YujiKF/PMR3420-RoboParalelo/README.md

# PMR3420-RoboParalelo
Tudo que é relevante ao desenvolvimento do robô paralelo para a matéria PMR3420, estão organizados os documentos necessários, códigos e uma Wiki explicando um pouco da teoria de cada componente.
