YujiKF/PMR3420-RoboParalelo/(list of files, cad)

Other CAD files:
Documentos/Mecânica/mecanismo/motor/cubo_e_eixo.ipt
Documentos/Mecânica/mecanismo/motor/eixo_motor.ipt
Documentos/Mecânica/mecanismo/motor/suporte_L_motor.ipt
Documentos/Mecânica/mecanismo/suporte_caneta.ipt
Mecânica/mecanismo/motor/OldVersions/cubo_e_eixo.0002.ipt
Mecânica/mecanismo/motor/OldVersions/motor_motando.0001.iam
