YujiKF/PMR3420-RoboParalelo/(threads)

Thread 2 (2025-03-29):

Desenvolvimento da placa

YujiKF, 2025-03-29:
Projetar a placa [necessária para o robô](https://github.com/YujiKF/PMR3420-RoboParalelo/blob/main/Documentos/Conexoes%20PI-7%202025.pdf), aqui. Cabe aqui fazer o esquemático e PCB da placa que será utilizada.

É importante saber que a placa será feita da mesma forma que a de PMR3406 (Microcontroladores), logo, será de apenas uma face e com restrições parecidas (tamanho, uso de jumpers na horizontal/vertical, etc).

Thread 4 (2025-03-29):

PCB

YujiKF, 2025-03-29:
Issue para acompanhar o desenvolvimento da PCB que será produzida com a mesma máquina de PMR3406.

Thread 5 (2025-03-29):

Compra de materiais

YujiKF, 2025-03-29:
Criação de[ planilha ](https://docs.google.com/spreadsheets/d/1Cy9gskSDtoIPbhkmRvqXv943JPoP1iQV_0-sLY41qnc/edit?usp=sharing) para seleção de materiais.
