YujiKF/PMR3420-RoboParalelo/Documentos/Esquemáticos/Esquemático PIC - PI7.pdf

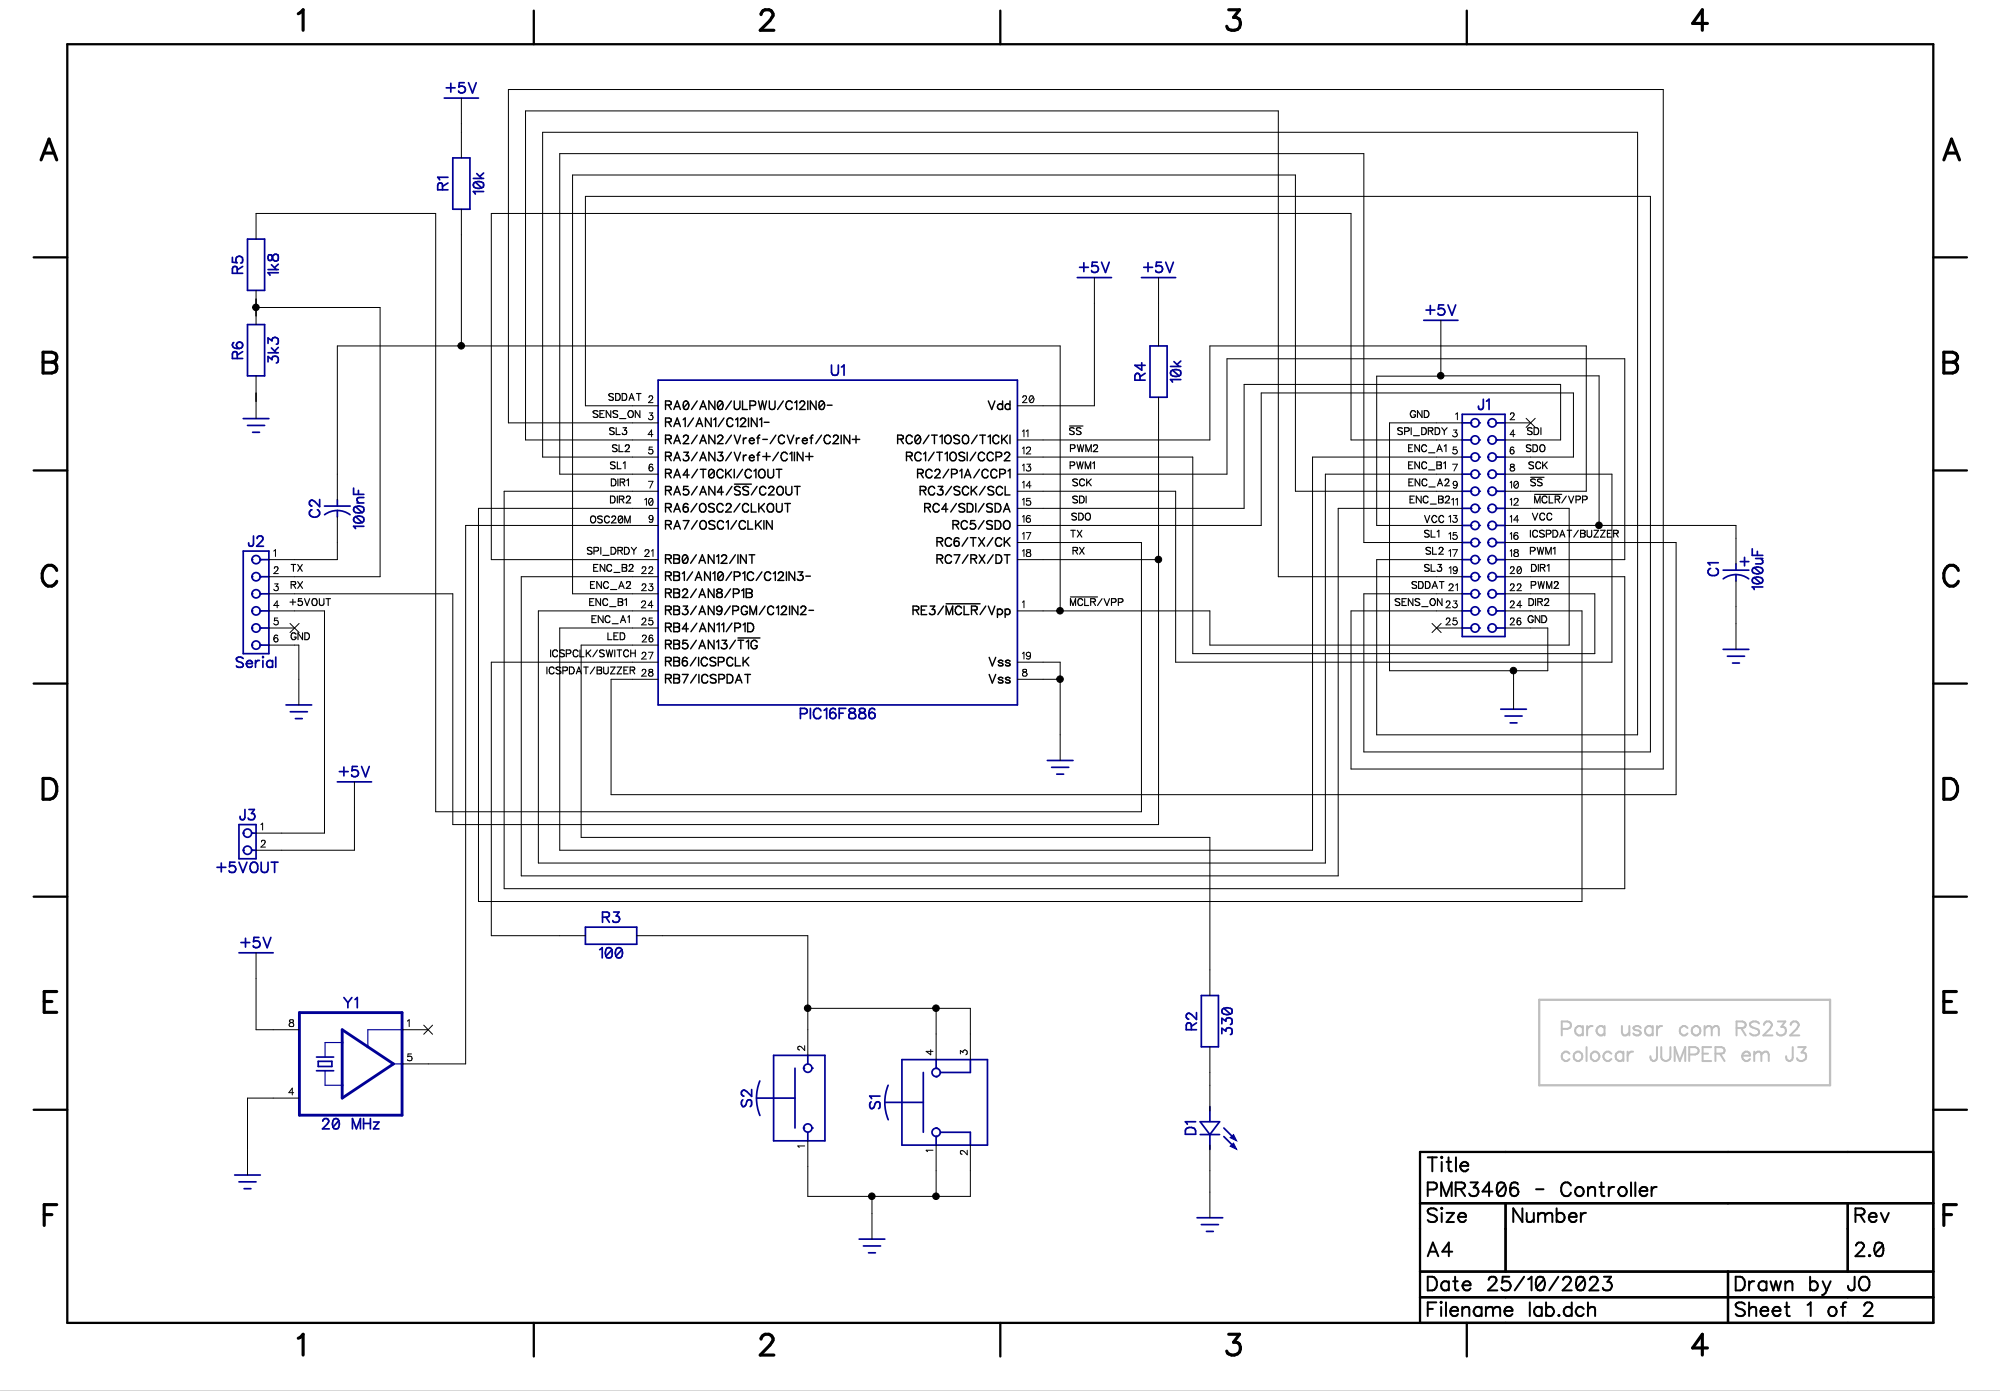
[picture p8: page 1]

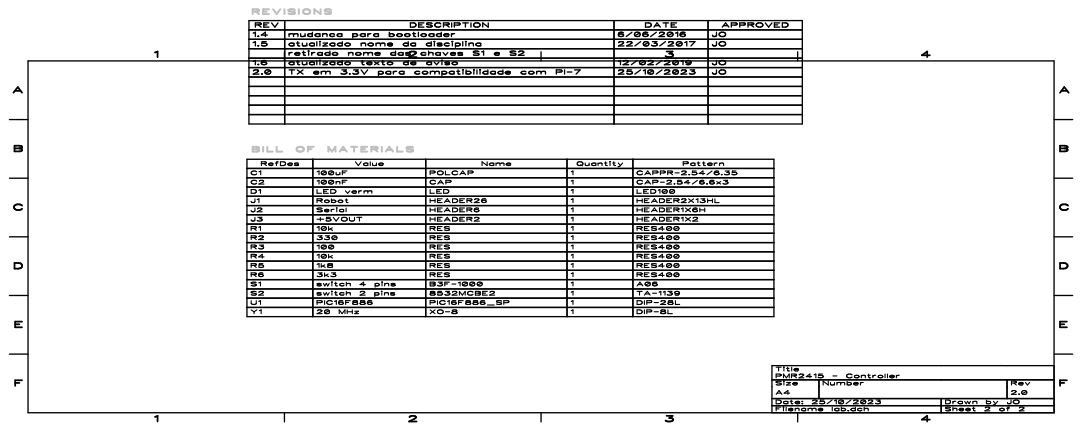
[picture p9: page 2]

DESCRIPTION mudanca para bootloader atualizado nome da disciplina retirado nome das chaves S | DATE 6/06/2016 22/03/2017 | APPROVED JOJO

1.6 2.0 | atualizado texto de aviso TX em 3.3V para compatibilidade com PI | 12/02/2019 25/10/2023 - | JOJO 7

Value 100uF 100nF LED verm Robot Serial +5VOUT 10k

Name POLCAP CAP LED HEADER26 HEADER6

HEADER
RES RES RES RES RES RES B3F

switch
4 pins switch 2 pins PIC16F886 20 MHz
