YujiKF/PMR3420-RoboParalelo/Documentos/Moodle/Conexoes PI-7 2025.pdf

M1

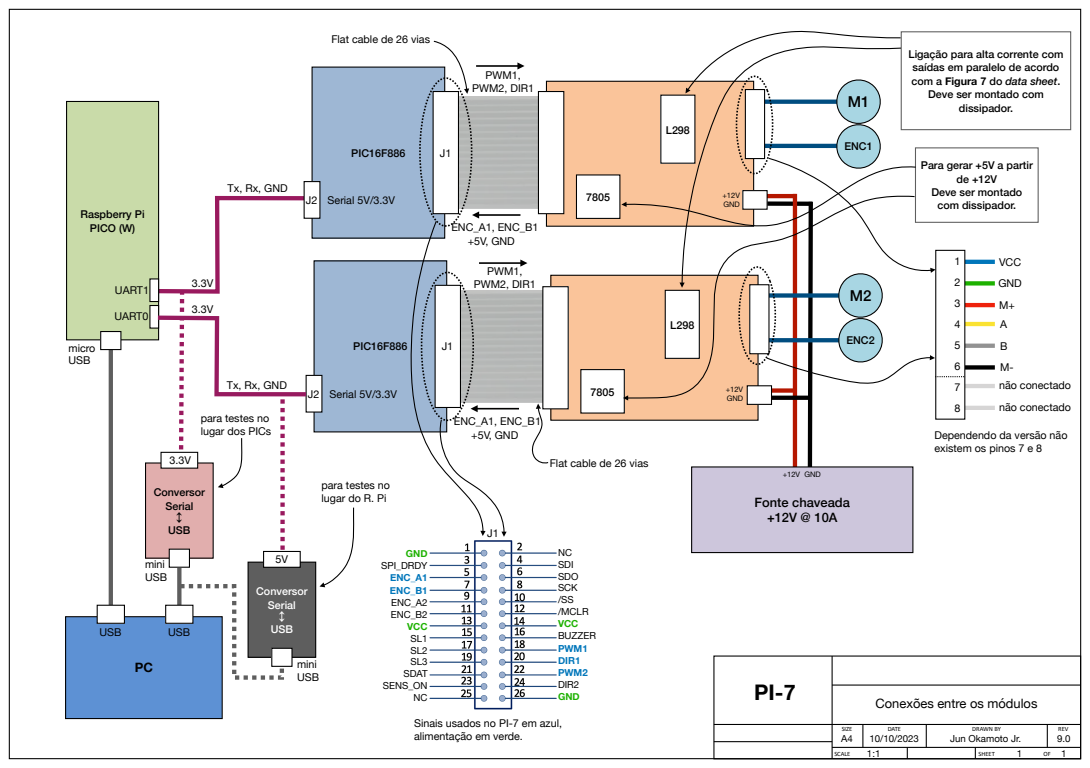
[picture p10: page 1]
SIZE; DATE; DRAWN BY; REV; SCALE; SHEET; Conexões entre os módulos; Jun Okamoto Jr.; micro USB; ENC1; Raspberry Pi PICO (W); UART0; UART1; PWM1, PWM2, DIR1; USB; Conversor Serial ↕︎ USB; PIC16F886; J2 Serial 5V/3.3V; ENC_A1, ENC_B1 +5V, GND; ENC2; Fonte chaveada +12V @ 10A; VCC; GND; não conectado; GND SPI_DRDY ENC_A1 ENC_B1 ENC_A2 ENC_B2 VCC SL1 SL2 SL3 SDAT SENS_ON NC; NC SDI SDO SCK /SS /MCLR VCC BUZZER PWM1 DIR1 PWM2 DIR2 GND; +12V GND; 5V mini USB; mini USB

Flat cable de 26 vias

Ligação para alta corrente com
saídas em paralelo de acordo
com a Figura 7 do data sheet.
Deve ser montado com
dissipador.

Para gerar +5V a partir
Deve ser montado
com dissipador.

Tx, Rx, GND

para testes no
lugar dos PICs

Dependendo da versão não
existem os pinos 7 e 8

lugar do R. Pi

Sinais usados no PI-7 em azul,
alimentação em verde.
