YujiKF/PMR3420-RoboParalelo/Documentos/Esquemáticos/Esquemático Giovanni - PI7.pdf

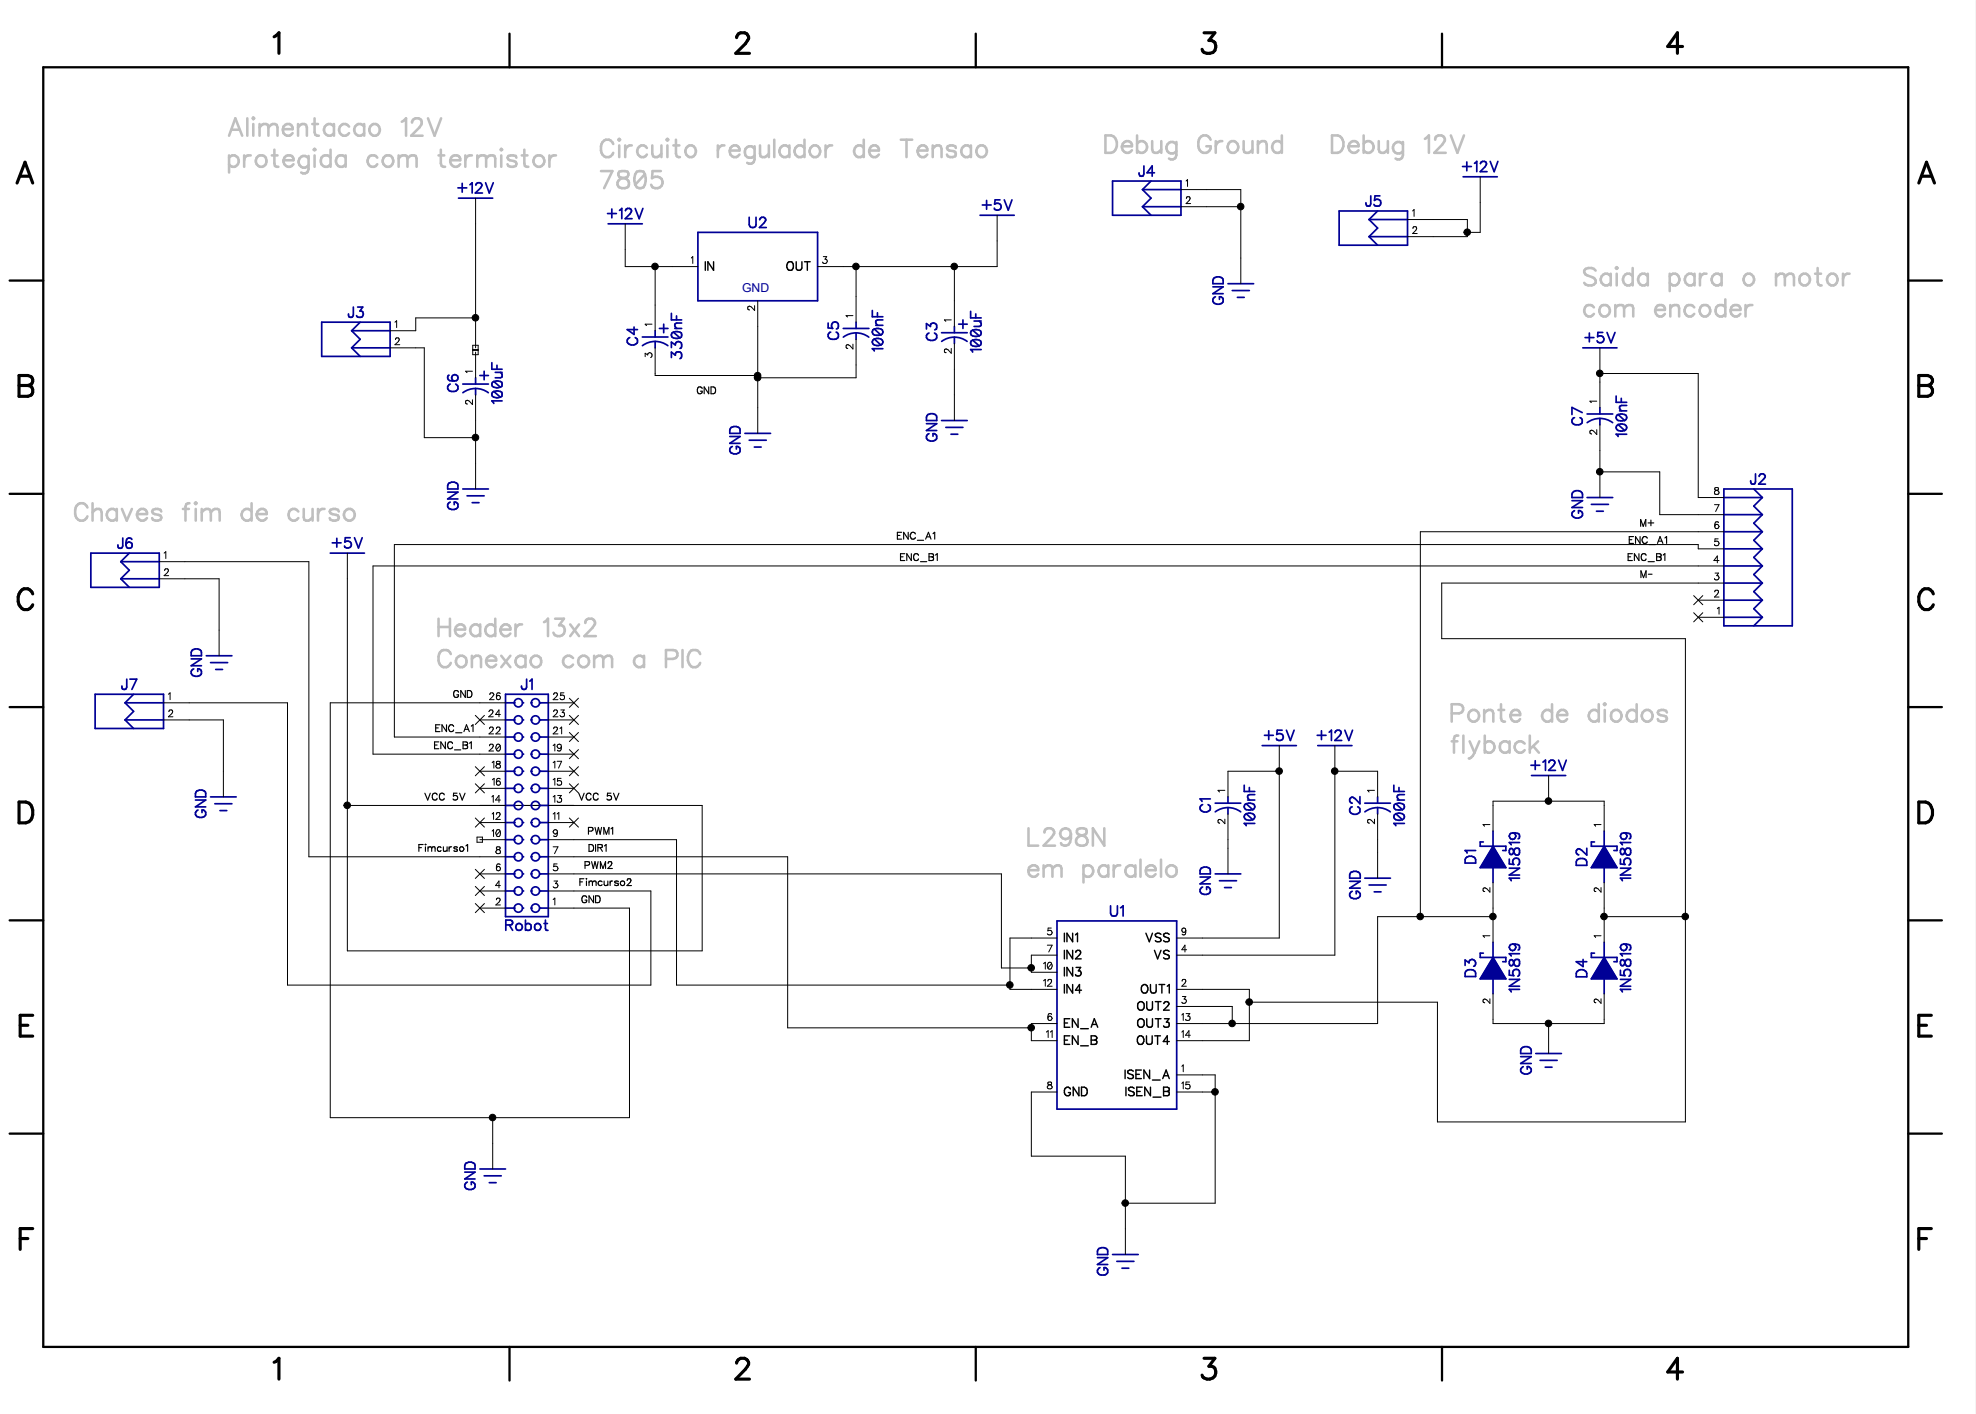
[picture p11: page 1]
