YujiKF/PMR3420-RoboParalelo/(list of files, drawings)

Other design files:
Documentos/Placa/pi7-pcb.dip
Documentos/Placa/pi7-pcb_default.dip
Documentos/Placa/pi7.dch
Eletrônica + Controle/Hardware/Esquemáticos/pi7-sch.dch
Eletrônica + Controle/Hardware/Esquemáticos/pi7-sch_sw_corrigido.dch
