YujiKF/PMR3420-RoboParalelo/Eletrônica + Controle/Software/ProjetoMPLAB/pidByPI7ORIGINAL/pidx.X/pwm.h

/*
 *	Header file for the PWM
 */
void pwm_init (void);
/*--------------------------------------------------------------- 
	Initialising the ADC channels 
	---------------------------------------------------------------*/
