YujiKF/PMR3420-RoboParalelo/Trajetória/GCodeLexer.py

# Generated from GCode.g4 by ANTLR 4.13.2
from antlr4 import *
from io import StringIO
import sys
if sys.version_info[1] > 5:
    from typing import TextIO
else:
    from typing.io import TextIO


def serializedATN():
    return [
        4,0,16,93,6,-1,2,0,7,0,2,1,7,1,2,2,7,2,2,3,7,3,2,4,7,4,2,5,7,5,2,
        6,7,6,2,7,7,7,2,8,7,8,2,9,7,9,2,10,7,10,2,11,7,11,2,12,7,12,2,13,
        7,13,2,14,7,14,2,15,7,15,1,0,1,0,1,0,1,0,1,1,1,1,1,1,1,1,1,2,1,2,
        1,2,1,2,1,3,1,3,1,3,1,3,1,4,1,4,1,4,1,4,1,5,1,5,1,6,1,6,1,7,1,7,
        1,8,1,8,1,9,1,9,1,10,1,10,1,10,1,11,3,11,68,8,11,1,11,1,11,1,11,
        3,11,73,8,11,1,12,1,12,1,13,4,13,78,8,13,11,13,12,13,79,1,14,3,14,
        83,8,14,1,14,1,14,1,15,4,15,88,8,15,11,15,12,15,89,1,15,1,15,0,0,
        16,1,1,3,2,5,3,7,4,9,5,11,6,13,7,15,8,17,9,19,10,21,11,23,12,25,
        13,27,14,29,15,31,16,1,0,3,2,0,43,43,45,45,1,0,48,57,2,0,9,9,32,
        32,97,0,1,1,0,0,0,0,3,1,0,0,0,0,5,1,0,0,0,0,7,1,0,0,0,0,9,1,0,0,
        0,0,11,1,0,0,0,0,13,1,0,0,0,0,15,1,0,0,0,0,17,1,0,0,0,0,19,1,0,0,
        0,0,21,1,0,0,0,0,23,1,0,0,0,0,25,1,0,0,0,0,27,1,0,0,0,0,29,1,0,0,
        0,0,31,1,0,0,0,1,33,1,0,0,0,3,37,1,0,0,0,5,41,1,0,0,0,7,45,1,0,0,
        0,9,49,1,0,0,0,11,53,1,0,0,0,13,55,1,0,0,0,15,57,1,0,0,0,17,59,1,
        0,0,0,19,61,1,0,0,0,21,63,1,0,0,0,23,67,1,0,0,0,25,74,1,0,0,0,27,
        77,1,0,0,0,29,82,1,0,0,0,31,87,1,0,0,0,33,34,5,71,0,0,34,35,5,48,
        0,0,35,36,5,48,0,0,36,2,1,0,0,0,37,38,5,71,0,0,38,39,5,48,0,0,39,
        40,5,49,0,0,40,4,1,0,0,0,41,42,5,71,0,0,42,43,5,48,0,0,43,44,5,50,
        0,0,44,6,1,0,0,0,45,46,5,71,0,0,46,47,5,48,0,0,47,48,5,51,0,0,48,
        8,1,0,0,0,49,50,5,77,0,0,50,51,5,51,0,0,51,52,5,48,0,0,52,10,1,0,
        0,0,53,54,5,88,0,0,54,12,1,0,0,0,55,56,5,89,0,0,56,14,1,0,0,0,57,
        58,5,73,0,0,58,16,1,0,0,0,59,60,5,74,0,0,60,18,1,0,0,0,61,62,5,82,
        0,0,62,20,1,0,0,0,63,64,5,78,0,0,64,65,3,27,13,0,65,22,1,0,0,0,66,
        68,3,25,12,0,67,66,1,0,0,0,67,68,1,0,0,0,68,69,1,0,0,0,69,72,3,27,
        13,0,70,71,5,46,0,0,71,73,3,27,13,0,72,70,1,0,0,0,72,73,1,0,0,0,
        73,24,1,0,0,0,74,75,7,0,0,0,75,26,1,0,0,0,76,78,7,1,0,0,77,76,1,
        0,0,0,78,79,1,0,0,0,79,77,1,0,0,0,79,80,1,0,0,0,80,28,1,0,0,0,81,
        83,5,13,0,0,82,81,1,0,0,0,82,83,1,0,0,0,83,84,1,0,0,0,84,85,5,10,
        0,0,85,30,1,0,0,0,86,88,7,2,0,0,87,86,1,0,0,0,88,89,1,0,0,0,89,87,
        1,0,0,0,89,90,1,0,0,0,90,91,1,0,0,0,91,92,6,15,0,0,92,32,1,0,0,0,
        6,0,67,72,79,82,89,1,6,0,0
    ]

class GCodeLexer(Lexer):

    atn = ATNDeserializer().deserialize(serializedATN())

    decisionsToDFA = [ DFA(ds, i) for i, ds in enumerate(atn.decisionToState) ]

    G00 = 1
    G01 = 2
    G02 = 3
    G03 = 4
    M30 = 5
    X = 6
    Y = 7
    I = 8
    J = 9
    R = 10
    LINE_NUMBER = 11
    VALUE = 12
    SIGN = 13
    DIGITS = 14
    EOL = 15
    WS = 16

    channelNames = [ u"DEFAULT_TOKEN_CHANNEL", u"HIDDEN" ]

    modeNames = [ "DEFAULT_MODE" ]

    literalNames = [ "<INVALID>",
            "'G00'", "'G01'", "'G02'", "'G03'", "'M30'", "'X'", "'Y'", "'I'", 
            "'J'", "'R'" ]

    symbolicNames = [ "<INVALID>",
            "G00", "G01", "G02", "G03", "M30", "X", "Y", "I", "J", "R", 
            "LINE_NUMBER", "VALUE", "SIGN", "DIGITS", "EOL", "WS" ]

    ruleNames = [ "G00", "G01", "G02", "G03", "M30", "X", "Y", "I", "J", 
                  "R", "LINE_NUMBER", "VALUE", "SIGN", "DIGITS", "EOL", 
                  "WS" ]

    grammarFileName = "GCode.g4"

    def __init__(self, input=None, output:TextIO = sys.stdout):
        super().__init__(input, output)
        self.checkVersion("4.13.2")
        self._interp = LexerATNSimulator(self, self.atn, self.decisionsToDFA, PredictionContextCache())
        self._actions = None
        self._predicates = None
