YujiKF/PMR3420-RoboParalelo/Eletrônica + Controle/Software/ProjetoMPLAB/pidYuji/HW_Test.X/lcd8x2_sim.c

/*
 * File:   lcd_sim.c
 * Author: Jun Okamoto Jr.
 *
 * Created on April 18, 2020, 12:58 PM
 * 
 * Updated: 13/05/2023 - configura carateres customizados para mostrar setas
 *          13/06/2024 - altera delay para usar built-in do XC8, precisa de "always.h"
 * 
 */

#include <xc.h>
#include "always.h"

#define LCD_EN RB0    // [jo:200418] Enable
#define LCD_RW RA3    // [jo:200418] Read/Write
#define LCD_RS RA2    // [jo:200418] Register Select

//#define	LCD_STROBE	((LCD_EN = 1),(LCD_EN=0))
// [jo:091210] Como o clock é 20MHz, o LCD_STROBE original produz um pulso de 200ns
//             A especificação do display é > 450ns no mínimo, assim é utilizado o
//             LCD_STROBE abaixo que produz cerca de 490ns. Rever no caso de alteração
//             na frequencia do clock.
#define	LCD_STROBE ((LCD_EN = 1),(LCD_EN = 1),(LCD_EN = 1),(LCD_EN = 0))

void LCD_RS_SetLow(void) {LCD_RS = 0;}
void LCD_RS_SetHigh(void) {LCD_RS = 1;}
void LCD_RW_SetLow(void) {LCD_RW = 0;}
void LCD_RW_SetHigh(void) {LCD_RW = 1;}

void lcd_write_nibble (unsigned char c) {
  RC0 = (c & 0b00000001) >> 0;
  RC3 = (c & 0b00000010) >> 1;
  RC4 = (c & 0b00000100) >> 2;
  RC5 = (c & 0b00001000) >> 3;
  
  LCD_STROBE;
}

/* Escreve 1 byte no LCD em interface de 4 bits */
void lcd_write(unsigned char c) {
  lcd_write_nibble(c >> 4);
  __delay_us(40);
  lcd_write_nibble(c);       // envia para o LCD
  __delay_us(40);
}

/* Limpa LCD e coloca cursor na 1a. posição da 1a. linha */
void lcd_clear(void) {
  LCD_RS_SetLow();  // é comando
  lcd_write(0x1);   // limpa o display e rotrona o cursor para posição 0
  __delay_ms(2);      // tem que esperar pois esse comando demora
}

/* Escreve string no LCD */
void lcd_puts(const char * s) {
  LCD_RS_SetHigh();	// é  dado
  while(*s)
    lcd_write(*s++);
}

/*  Posiciona o cursor  */
void lcd_goto(unsigned char pos) {
  LCD_RS_SetLow();        // é  comando
  lcd_write(0x80 + pos);  // comando na forma 0b1eeeeeee, onde eeeeeee é o 
                          // endereço da posição do cursor com 7-bits
                          //   se eeeeeee entre 0 e 40 - 1a. linha
                          //   se eeeeeee entre 64 e 104 - 2a. linha
}

/*  Liga/desliga cursor */
void lcd_show_cursor(int on) {
  LCD_RS_SetLow();   // é comando
  if (on) {          // se on for true - liga
    lcd_write(0x0f); //   display on, cursor on, blink on
  } else {           // se on for false - desliga
    lcd_write(0x0c); //   display on, cursor off, blink off
  }
}

/*  Escreve um caracter no display  */
void lcd_putchar(char c) {
  LCD_RS_SetHigh();  // é dado
  lcd_write(c);      // coloca caracter no display na posição atual do cursor
}

// [jo:230513] Carateres customizados
#define CHAR_DATA_SIZE 64  // [jo:160212] era 48

const uint8_t batt_char_data[] = 
{ 0x1f, 0x10, 0x10, 0x10, 0x10, 0x10, 0x10, 0x1f,   // start char
  0x1f, 0x10, 0x17, 0x17, 0x17, 0x17, 0x10, 0x1f,   // start filled char
  0x1f, 0x00, 0x00, 0x00, 0x00, 0x00, 0x00, 0x1f,   // middle char
  0x1f, 0x00, 0x1f, 0x1f, 0x1f, 0x1f, 0x00, 0x1f,   // middle filled char
  0x1e, 0x02, 0x01, 0x01, 0x01, 0x01, 0x02, 0x1e,   // end char
  0x1e, 0x02, 0x1d, 0x1d, 0x1d, 0x1d, 0x02, 0x1e,   // end filled char
  0x04, 0x0e, 0x15, 0x04, 0x04, 0x04, 0x04, 0x00,   // [jo:160212] up arrow
  0x04, 0x04, 0x04, 0x04, 0x15, 0x0e, 0x04, 0x00    // [jo:160212] down arrow
};

 // Escreve os caracteres customizados na CGRAM
void lcd_load_custom_chars() {
  // DefiniÁ?o de caracteres
  LCD_RS_SetLow();
  lcd_write(0x40);  // primeira linha do primeiro caracter
  
  // dados dos caracteres
  LCD_RS_SetHigh();
  for (uint8_t i = 0; i < CHAR_DATA_SIZE; i++)
    lcd_write(batt_char_data[i]);
}
// [jo:230513] Caracteres customizados - fim

/* Inicializa LCD com interface de 4-bits */
void lcd_init(void) {
  // configura portas de I/O
  TRISB0 = 0;           // RB0 = ENABLE é saída
  ANS12 = 0;            // RB0 é digital
  TRISA3 = 0;           // RA3 = RW é saída
  ANS3 = 0;             // RA3 é digital
  TRISA2 = 0;           // RA2 = RS é saída
  ANS2 = 0;             // RA2 é digital
  TRISC &= 0b11000110; // Saídas: RC5 = DB7, RC4 = DB6, RC3 = DB5, RC0 = DB4
  LCD_EN = 0;           // ENABLE no estado inicial
  
  LCD_RW_SetLow();      // modo de escrita
  LCD_RS_SetLow();	    // é comando
  __delay_ms(15);	        // espera o display incializar
  lcd_write(0x02);      // define interface de 4-bits
  __delay_ms(2);          // espera obrigatória
  lcd_write(0x28);      // 4 bit mode, 1/16 duty, 5x8 font
  lcd_write(0x08);      // desliga display
  lcd_write(0x0f);      // liga display, liga cursor
  lcd_write(0x06);      // entrada de dados é para a direita e cursor é auto-incrementado
  
  lcd_load_custom_chars(); // [jo:230513] para mostrar setas no teste 5, 6 e 7
}
