YujiKF/PMR3420-RoboParalelo/(commit log)

2025-04-05 Adicionando o datasheet do regulador 5V L7805CV da STMicroeletronics
2025-04-06 Começando o esquemático, talvez esteja finalizado mas falta verificar algumas coisas, conferir a Wiki para mais detalhes.
2025-04-06 Adicionando biblioteca para o esquemático, tutorial na Wiki sobre como utilizar
2025-04-11 Adicionado diodos de flyback no esquemático
2025-04-17 Criado arquivo vazio para a pasta mecânica aparecer
2025-04-27 Esquemático devidamente finalizado. Atualizações na Issue do Esquemático e na Wiki. Diodo escolhido e adicionado headers para debug.
2025-04-27 Posicionamento inicial dos componentes na PCB. Sujeito a mudanças!
2025-04-27 CAD do mecanismo
2025-04-29 Adicionada informações necessárias no esquemático, conforme página 38 do slide de documentação (https://edisciplinas.usp.br/pluginfile.php/8926306/mod_resource/content/1/PI7eDocumenta%C3%A7%C3%A3o_El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
2025-04-30 Feita versão 1 da PCB, o problema é que usa um jumper e o posicionamento não tá dos melhores.
2025-05-03 Adicionado esquemático e PCB com chaves de contato, com o final -SW no nome do arquivo. Além disso foram feitas atualizações na PCB original, tudo pronto, talvez conste mudar a top silk, mas só.
2025-05-04 minha versao da pcb, tem 2 jumpers
2025-05-07 Adicionando holes na placa
2025-05-07 Alterando tamanho dos holes para serem o mesmo do header, já que supostamente ele é obrigatório e o tamanho do hole não pode ser alterado facilmente, presumo que seja possível produzir.
2025-05-20 Adicionado Gerber para fabricação.
2025-05-21 Adicionando esquemático semi corrigido, faltam capacitores de 100nF para cada uma das alimentações do driver.
2025-06-04 Removendo arquivos desnecessários de PCB e esquemático
2025-06-04 Modificando hierarquia de pastas e removendo arquivos desnecessários de PCB e esquemático
2025-06-04 Adicionando esquemático do Giovanni para consulta.
2025-06-04 Adicionando todos os esquemáticos, do driver do giovanni, do nosso e do PIC
2025-06-06 Adicionando arquivos de simulação e projeto do MPLAB
2025-06-11 Remove o submódulo pidx.X para convertê-lo em uma pasta normal
2025-06-11 Adicionando arquivos .hex para dar flash na placa do PIC
2025-06-12 Adicionando novas versões para o código da comunicação serial.
2025-06-12 Adicionando arquivos compilados para o serial.
2025-06-20 Tirando a pasta de serial desnecessária.
2025-06-20 Adicionando hexadecimais para flash para teste de encoder.
2025-07-06 Código novo. Completamente funcional. Ajustes de ganhos são necessários.
